vbattar1/fitnessBuddy/schematicNotes.txt.txt

Digital Output
CS.OLED
RESET.OLED
DC.OLED
(SPI)
(I2C)
SD.CS
(Optional) Card Detect 1 and 2
Digital Inputs
3x Buttons
Charge Status

Analog Inputs
Battery Monitor

Analog Outputs

Data to send to bottom board
3.3V
GND
I2C
TIA
2-3x GPIO
PPG (Pulse Sensor Circuit Output)

TOP BOARD
pins:

Power management
D27/CHRG.STATUS (Input)
A4/BATT (Input)

PPG Circuit
D29/LED.CTRL (Output)
A6/TIA (Input)
A7/PPG (Input)

OLED Pins
D3/RESET.OLED (Output)
D4/DC.OLED (Output)
D16/CS.OLED (Output)

SD Card
D5/CD1 (Input)
D7/SD.CS (Output)

Buttons Inputs
D11/SW1 (Input)
D15/SW2 (Input)
