vbattar1/fitnessBuddy/fitnessBuddy.docx

Smartwatch name: Fitness Buddy

Desired capabilities:

- Count steps
- Tell time
- Keep track of heart rate
- Keep track of calorie intake
- Goal tracking
- Blood sugar levels
- Blood pressure
- Show phone notifications
- Body temperature
- Gps
- Play music
