vbattar1/fitnessBuddy/Hardware/Top/fitnessBuddy-TOP.brd

## EAGLE design Hardware/Top/fitnessBuddy-TOP.brd (2020-10-20)

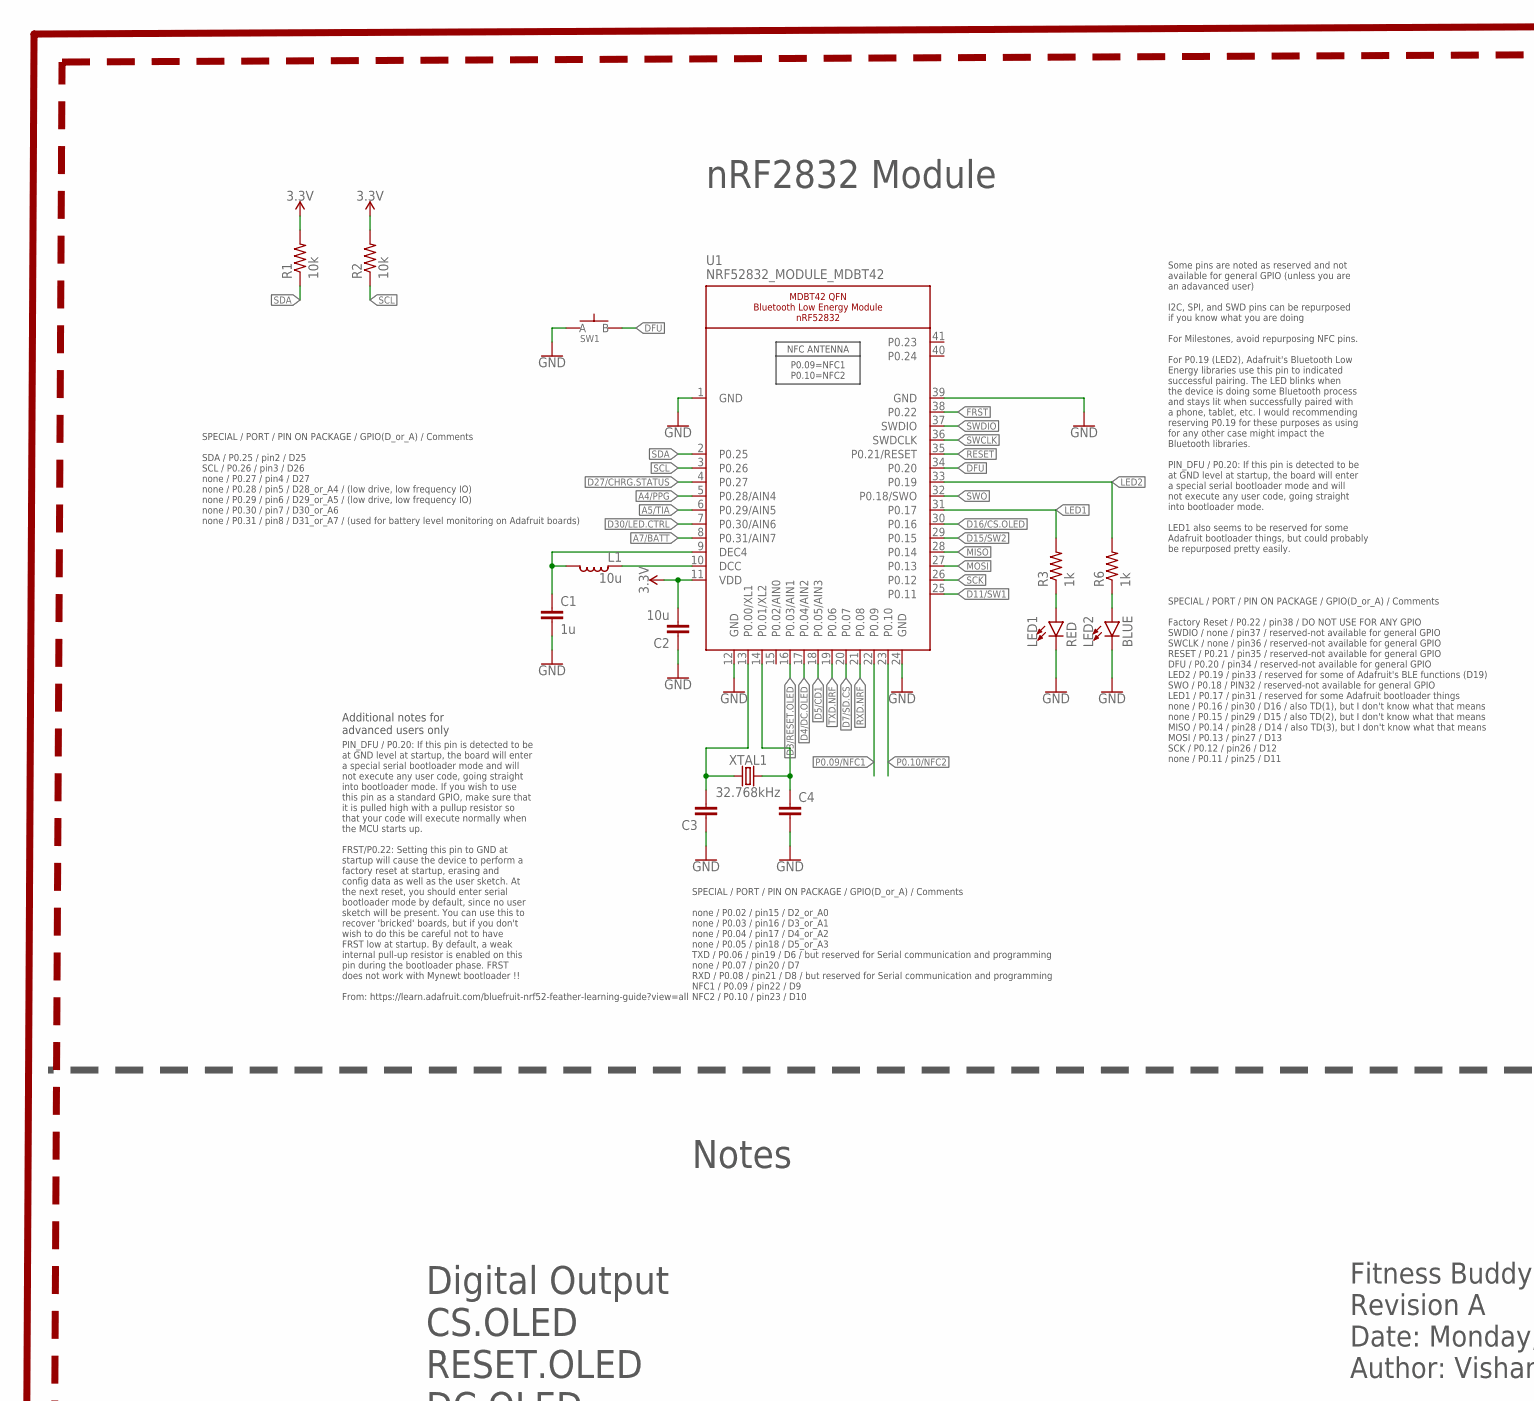
[picture p6: schematic fitnessBuddy-TOP.sch, part in row 1, column 1]

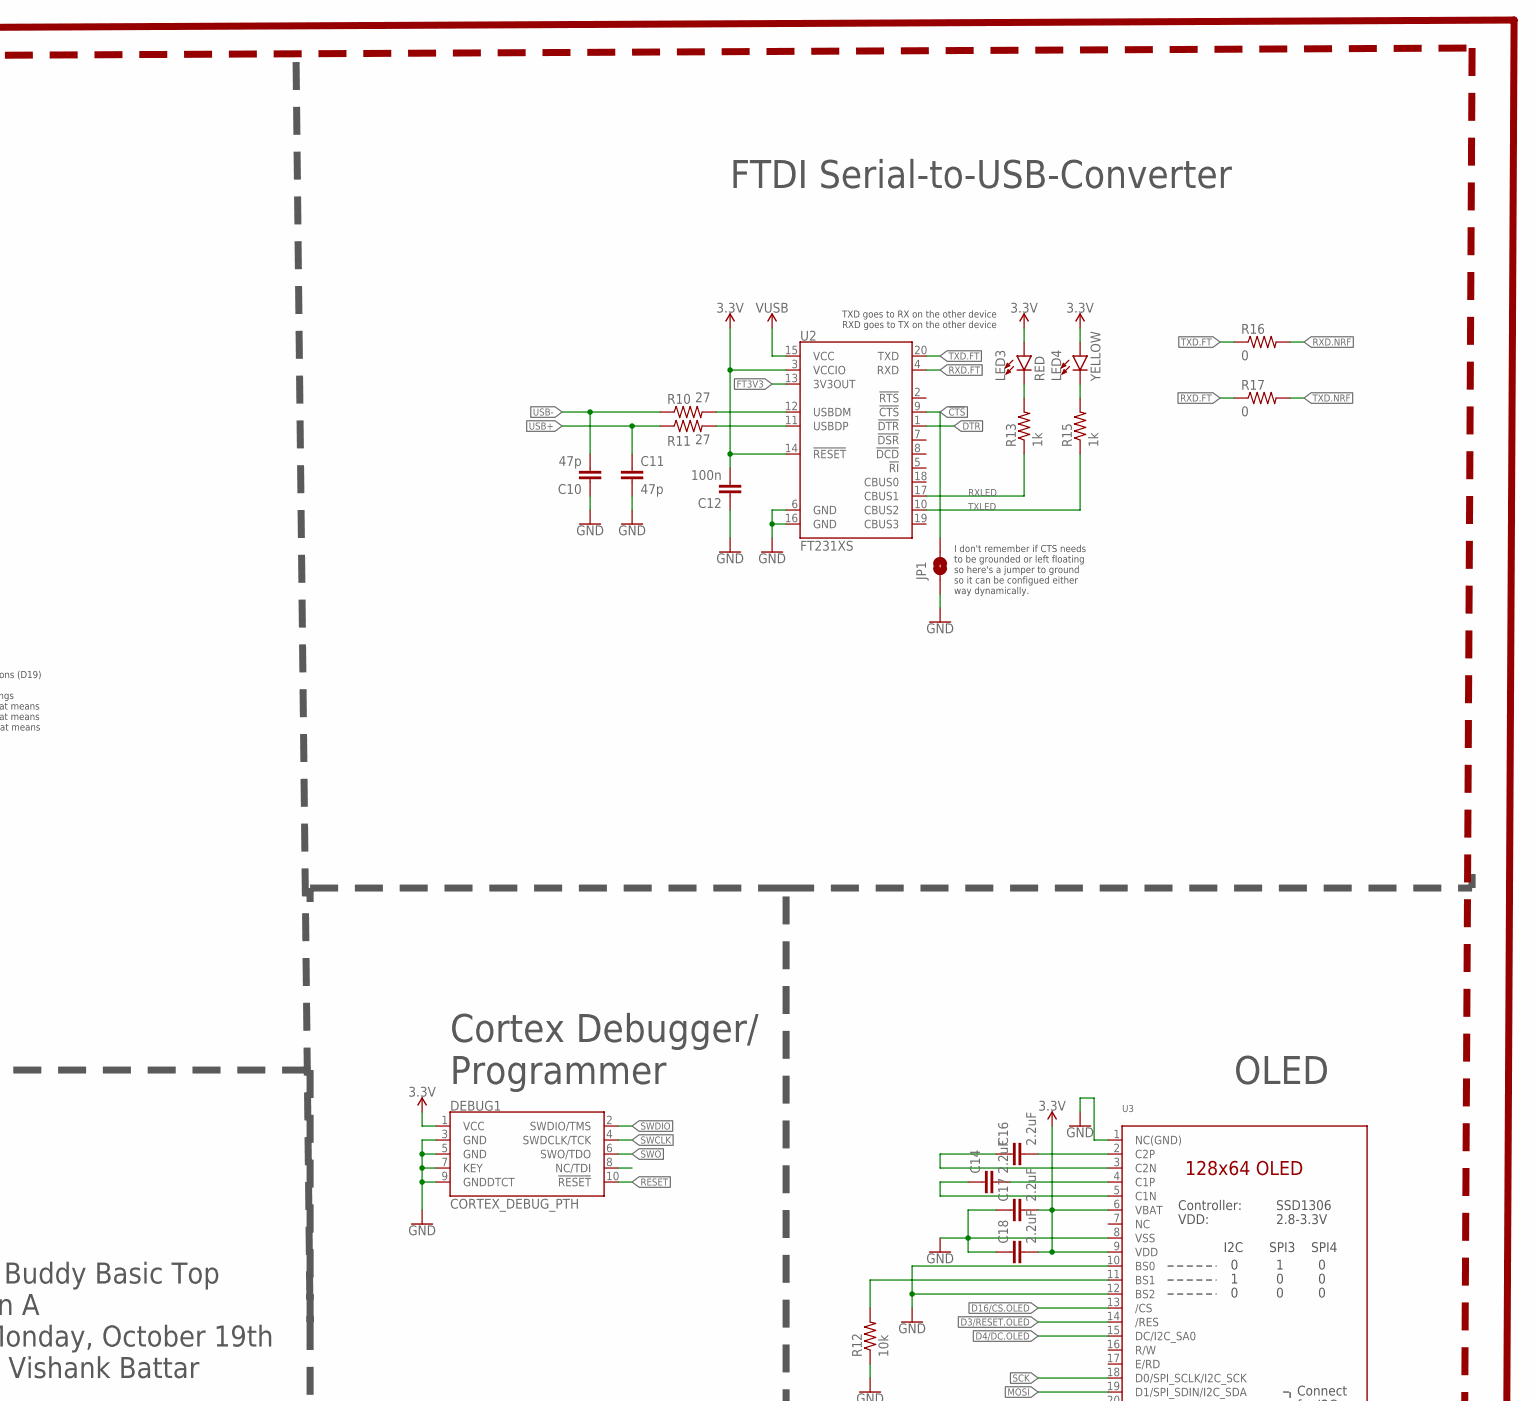
[picture p7: schematic fitnessBuddy-TOP.sch, part in row 1, column 2]

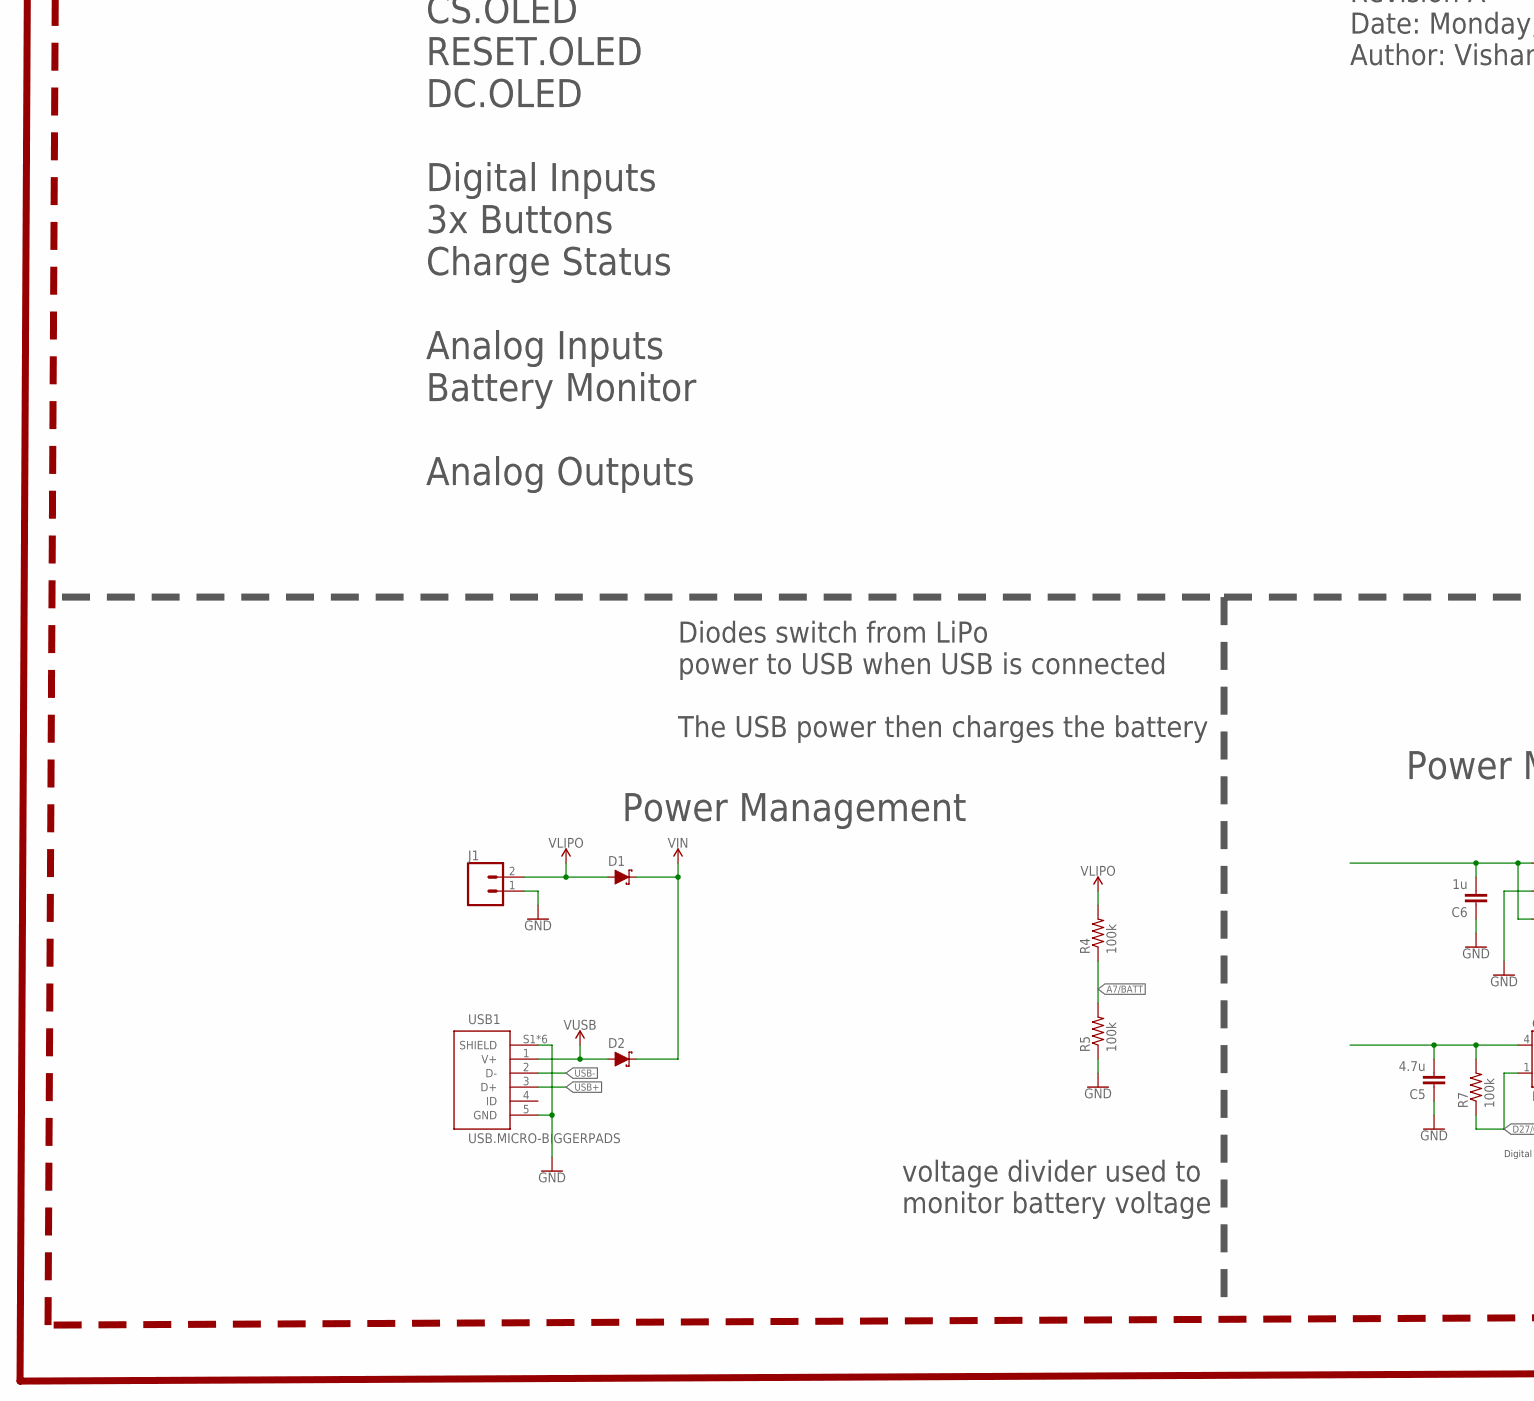
[picture p8: schematic fitnessBuddy-TOP.sch, part in row 2, column 1]

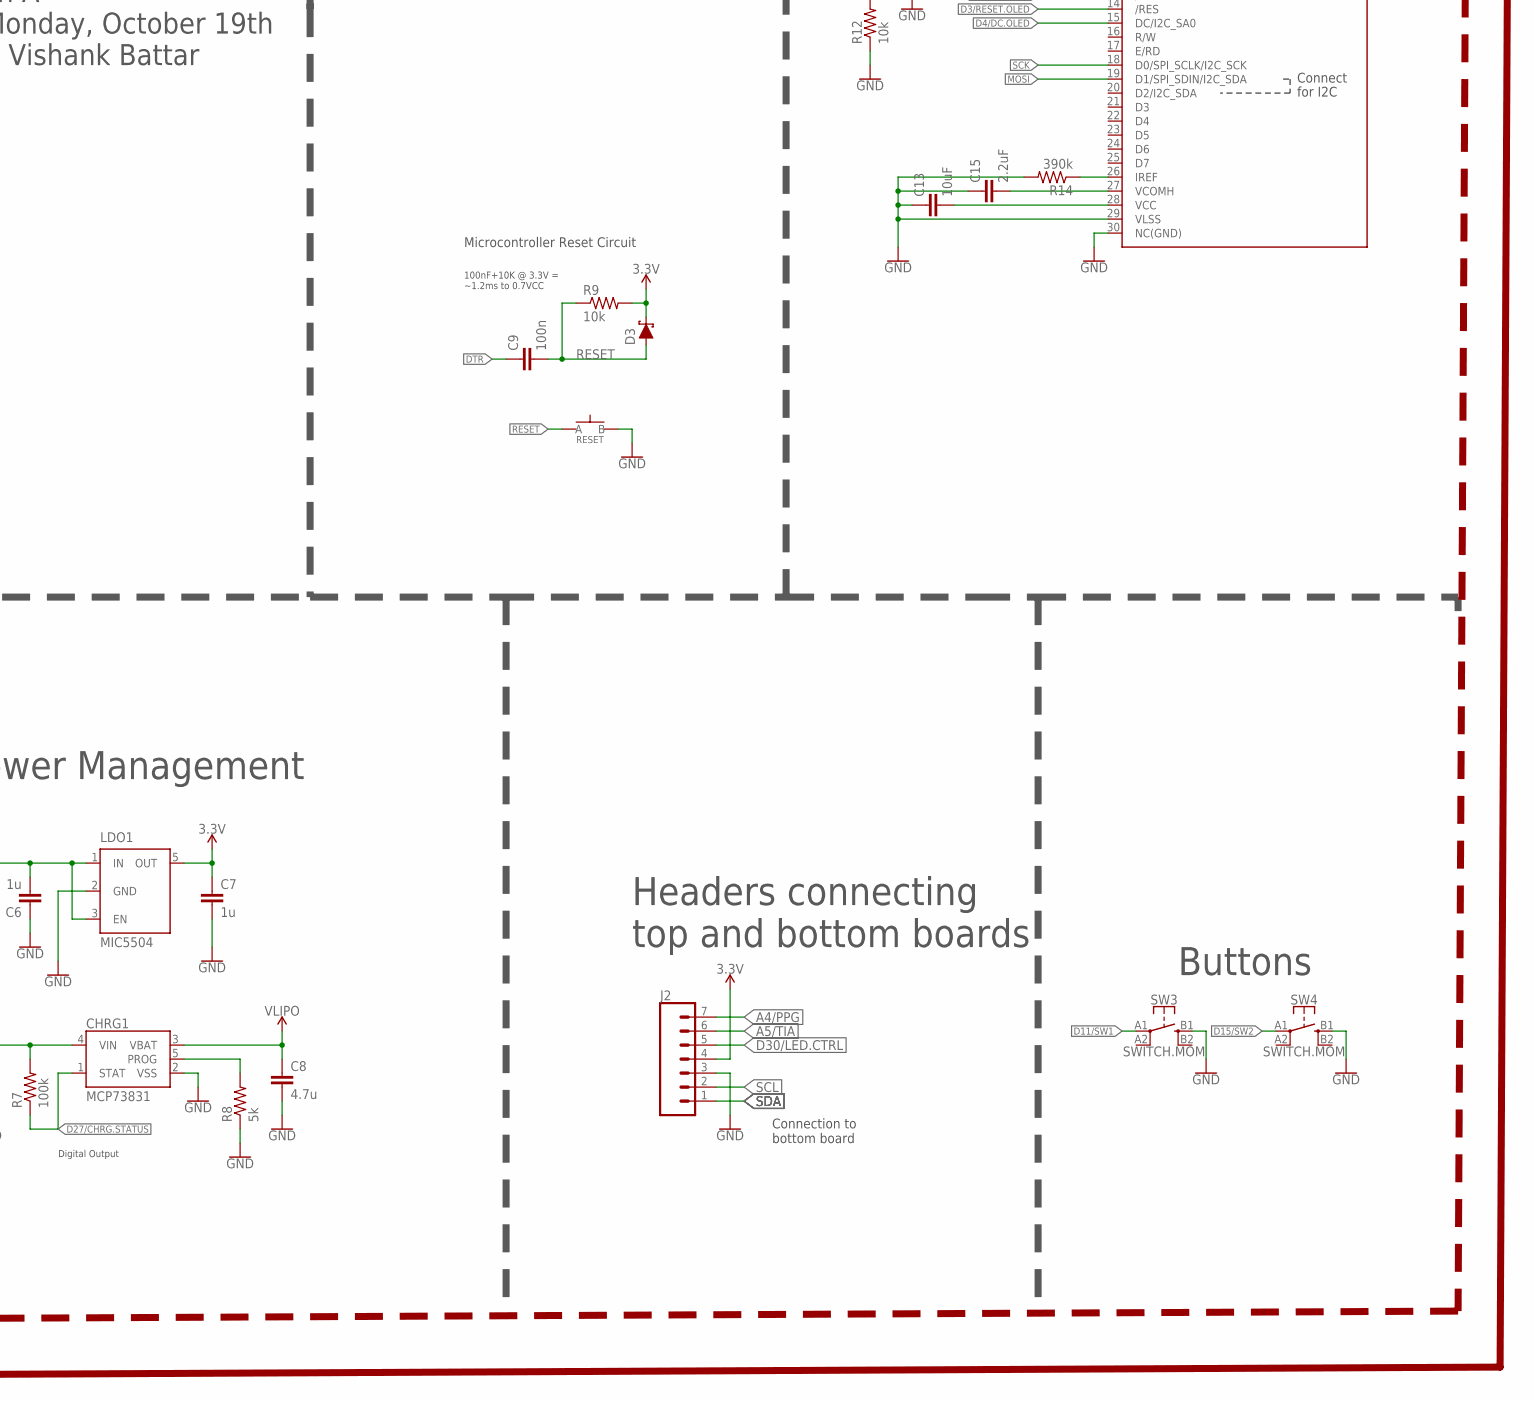
[picture p9: schematic fitnessBuddy-TOP.sch, part in row 2, column 2]

Parts:
C1, C6, C7: 1u; C0603
C2: 10u; C0805
C3, C4: CAPACITOR0603; C0603
C5, C8: 4.7u; C0603
C9, C12: 100n; C0603
C10, C11: 47p; C0603
C13: 10uF; C0603
C14, C16, C17, C18: 2.2uF; C0402
C15: 2.2uF; C0603
CHRG1: MCP73831; SOT23-5
D1, D2, D3: SCHOTTKY-USC; USC
DEBUG1: CORTEX_DEBUG_PTH; 2X5-PTH-1.27MM
J1: CONN_02; 1X02
J2: CONN_07-1.27MM; 1X07_1.27MM
JP1: JUMPER-SMT_2_NO_SILK; SMT-JUMPER_2_NO_SILK
L1: 10u; L0603
LDO1: MIC5504; SOT23-5
LED1, LED3: RED; LED-0603
LED2: BLUE; LED-0603
LED4: YELLOW; LED-0603
R1, R2, R9, R12: 10k; R0603
R3, R6, R13, R15: 1k; R0603
R4, R5, R7: 100k; R0603
R8: 5k; R0603
R10, R11: 27; R0603
R14: 390k; R0603
R16, R17: 0; R0603
RESET: SPST-PTS830GG140-COPY.1-3; BUTTON-GULLWING
SW1: SPST-PTS830GG140-COPY.1-3; BUTTON-GULLWING
SW3, SW4: SWITCH.MOM; TACTILE_SWITCH_SMD_6.2MM_TALL
U1: NRF52832_MODULE_MDBT42; BLE_MODULE_RAYTAC_MDBT42
U2: FT231XS; SSOP20_L
U3: DISP_OLED_UG-2864HSWEG01-NO-WRAPAROUND; UG-2864HSWEG01_0.96IN_NO-WRAPAROUND
USB1: USB.MICRO-BIGGERPADS; USB-MICRO-01.BIGGERPADS
XTAL1: 32.768kHz; 2-SMD.NOLEAD.2.0MMTO1.2MM

Connections:
3.3V: C2.2, C7.1, C12.2, C17.2, C18.2, D3.- (C), DEBUG1.1 (VCC), J2.4, LDO1.5 (OUT), LED3.A, LED4.A, R1.2, R2.2, R9.2, U1.11 (VDD), U2.3 (VCCIO), U2.14 (!RESET), U3.6 (VBAT), U3.9 (VDD)
!CTS: JP1.2, U2.9 (!CTS)
A4/PPG: J2.7, U1.5 (P0.28/AIN4)
A5/TIA: J2.6, U1.6 (P0.29/AIN5)
A7/BATT: R4.1, R5.2, U1.8 (P0.31/AIN7)
D3/RESET.OLED: U1.16 (P0.03/AIN1), U3.14 (/RES)
D4/DC.OLED: U1.17 (P0.04/AIN2), U3.15 (DC/I2C_SA0)
D5/CD1: U1.18 (P0.05/AIN3)
D7/SD.CS: U1.20 (P0.07)
D11/SW1: SW3.A1 (1), U1.25 (P0.11)
D15/SW2: SW4.A1 (1), U1.29 (P0.15)
D16/CS.OLED: U1.30 (P0.16), U3.13 (/CS)
D27/CHRG.STATUS: CHRG1.1 (STAT), R7.1, U1.4 (P0.27)
D30/LED.CTRL: J2.5, U1.7 (P0.30/AIN6)
DFU: SW1.3 (B), U1.34 (P0.20)
DTR: C9.1, U2.1 (!DTR)
FRST: U1.38 (P0.22)
FT3V3: U2.13 (3V3OUT)
GND: C1.2, C2.1, C3.1, C4.2, C5.1, C6.1, C7.2, C8.2, C10.1, C11.2, C12.1, C13.1, C15.1, C17.1, C18.1, CHRG1.2 (VSS), DEBUG1.3 (GND), DEBUG1.5 (GND), DEBUG1.7 (KEY), DEBUG1.9 (GNDDTCT), J1.1, J2.3, JP1.1, LDO1.2 (GND), LED1.C, LED2.C, R5.1, R8.1, R12.1, R14.2, RESET.3 (B), SW1.1 (A), SW3.B1 (3), SW4.B1 (3), U1.1 (GND), U1.12 (GND), U1.24 (GND), U1.39 (GND), U2.6 (GND), U2.16 (GND), U3.1 (NC(GND)), U3.8 (VSS), U3.10 (BS0), U3.12 (BS2), U3.29 (VLSS), U3.30 (NC(GND)), USB1.5 (GND), USB1.S1 (SHIELD), USB1.S2 (SHIELD), USB1.S3 (SHIELD), USB1.S4 (SHIELD), USB1.S5 (SHIELD), USB1.S6 (SHIELD)
LED1: R3.2, U1.31 (P0.17)
LED2: R6.2, U1.33 (P0.19)
MISO: U1.28 (P0.14)
MOSI: U1.27 (P0.13), U3.19 (D1/SPI_SDIN/I2C_SDA)
unnamed: R12.2, U3.11 (BS1)
unnamed: R14.1, U3.26 (IREF)
unnamed: C16.2, U3.2 (C2P)
unnamed: C3.2, U1.13 (P0.00/XL1), XTAL1.P$1 (1)
unnamed: C16.1, U3.3 (C2N)
unnamed: C4.1, U1.14 (P0.01/XL2), XTAL1.P$2 (2)
unnamed: C14.2, U3.4 (C1P)
unnamed: C14.1, U3.5 (C1N)
unnamed: LED1.A, R3.1
unnamed: LED2.A, R6.1
unnamed: L1.1, U1.10 (DCC)
unnamed: C1.1, L1.2, U1.9 (DEC4)
unnamed: C13.2, U3.28 (VCC)
unnamed: C15.2, U3.27 (VCOMH)
unnamed: CHRG1.5 (PROG), R8.2
unnamed: C5.2, CHRG1.4 (VIN), R7.2
unnamed: R10.2, U2.12 (USBDM)
unnamed: R11.2, U2.11 (USBDP)
unnamed: LED3.C, R13.2
unnamed: LED4.C, R15.2
P0.09/NFC1: U1.22 (P0.09)
P0.10/NFC2: U1.23 (P0.10)
RESET: C9.2, D3.+ (A), DEBUG1.10 (!RESET), R9.1, RESET.1 (A), U1.35 (P0.21/RESET)
RXD.FT: R17.1, U2.4 (RXD)
RXD.NRF: R16.2, U1.21 (P0.08)
RXLED: R13.1, U2.17 (CBUS1)
SCK: U1.26 (P0.12), U3.18 (D0/SPI_SCLK/I2C_SCK)
SCL: J2.2, R2.1, U1.3 (P0.26)
SDA: J2.1, R1.1, U1.2 (P0.25)
SWCLK: DEBUG1.4 (SWDCLK/TCK), U1.36 (SWDCLK)
SWDIO: DEBUG1.2 (SWDIO/TMS), U1.37 (SWDIO)
SWO: DEBUG1.6 (SWO/TDO), U1.32 (P0.18/SWO)
TXD.FT: R16.1, U2.20 (TXD)
TXD.NRF: R17.2, U1.19 (P0.06)
TXLED: R15.1, U2.10 (CBUS2)
USB+: C11.1, R11.1, USB1.3 (D+)
USB-: C10.2, R10.1, USB1.2 (D-)
VIN: C6.2, D1.- (C), D2.- (C), LDO1.1 (IN), LDO1.3 (EN)
VLIPO: C8.1, CHRG1.3 (VBAT), D1.+ (A), J1.2, R4.2
V_USB: D2.+ (A), U2.15 (VCC), USB1.1 (V+)

Notes on the sheet:
Microcontroller Reset Circuit
100nF+10K @ 3.3V = ~1.2ms to 0.7VCC
SPECIAL / PORT / PIN ON PACKAGE / GPIO(D_or_A) / Comments SDA / P0.25 / pin2 / D25 SCL / P0.26 / pin3 / D26 none / P0.27 / pin4 / D27 none / P0.28 / pin5 / D28_or_A4 / (low drive, low frequency IO) none / P0.29 / pin6 / D29_or_A5 / (low drive, low frequency IO) none / P0.30 / pin7 / D30_or_A6 none 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
SPECIAL / PORT / PIN ON PACKAGE / GPIO(D_or_A) / Comments none / P0.02 / pin15 / D2_or_A0 none / P0.03 / pin16 / D3_or_A1 none / P0.04 / pin17 / D4_or_A2 none / P0.05 / pin18 / D5_or_A3 TXD / P0.06 / pin19 / D6 / but reserved for Serial communication and programming none / P0.07 / pin20 / D7 RXD / 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
SPECIAL / PORT / PIN ON PACKAGE / GPIO(D_or_A) / Comments Factory Reset / P0.22 / pin38 / DO NOT USE FOR ANY GPIO SWDIO / none / pin37 / reserved-not available for general GPIO SWCLK / none / pin36 / reserved-not available for general GPIO RESET / P0.21 / pin35 / reserved-not available for general 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
Some pins are noted as reserved and not available for general GPIO (unless you are an adavanced user) I2C, SPI, and SWD pins can be repurposed if you know what you are doing For Milestones, avoid repurposing NFC pins. For P0.19 (LED2), Adafruit's Bluetooth Low Energy libraries use this pin to indic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
PIN_DFU / P0.20: If this pin is detected to be at GND level at startup, the board will enter a special serial bootloader mode and will not execute any user code, going straight into bootloader mode. If you wish to use this pin as a standard GPIO, make sure that it is pulled high with a pullup resis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
Additional notes for advanced users only
nRF2832 Module
OLED
Power Management
Buttons
Cortex Debugger/ Programmer
Digital Output CS.OLED RESET.OLED DC.OLED Digital Inputs 3x Buttons Charge Status Analog Inputs Battery Monitor Analog Outputs
TXD goes to RX on the other device RXD goes to TX on the other device
I don't remember if CTS needs to be grounded or left floating so here's a jumper to ground so it can be configued either way dynamically.
FTDI Serial-to-USB-Converter
Notes
Connection to bottom board
Digital Output
Fitness Buddy Basic Top Revision A Date: Monday, October 19th Author: Vishank Battar
Diodes switch from LiPo power to USB when USB is connected The USB power then charges the battery
voltage divider used to monitor battery voltage
Headers connecting top and bottom boards

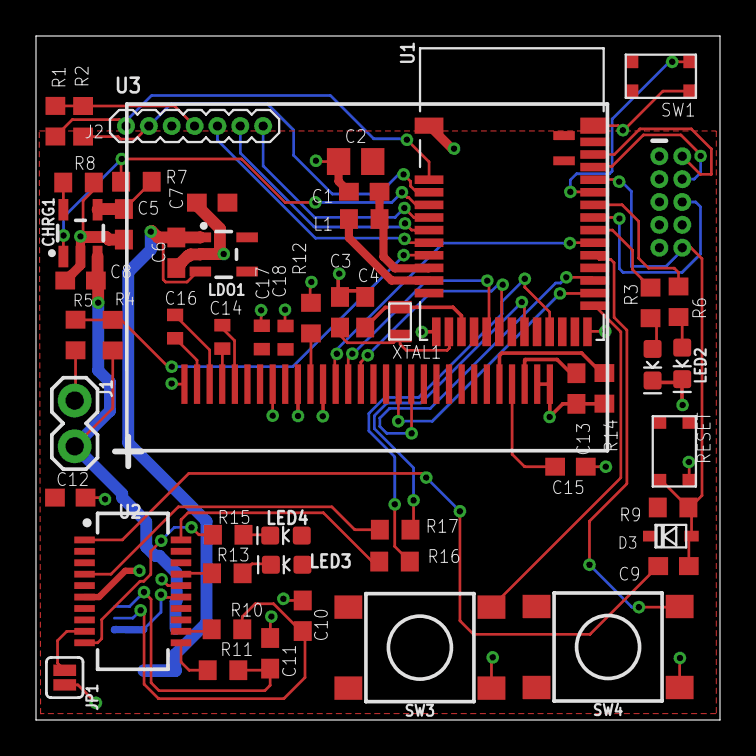
[picture p10: board fitnessBuddy-TOP.brd from above]

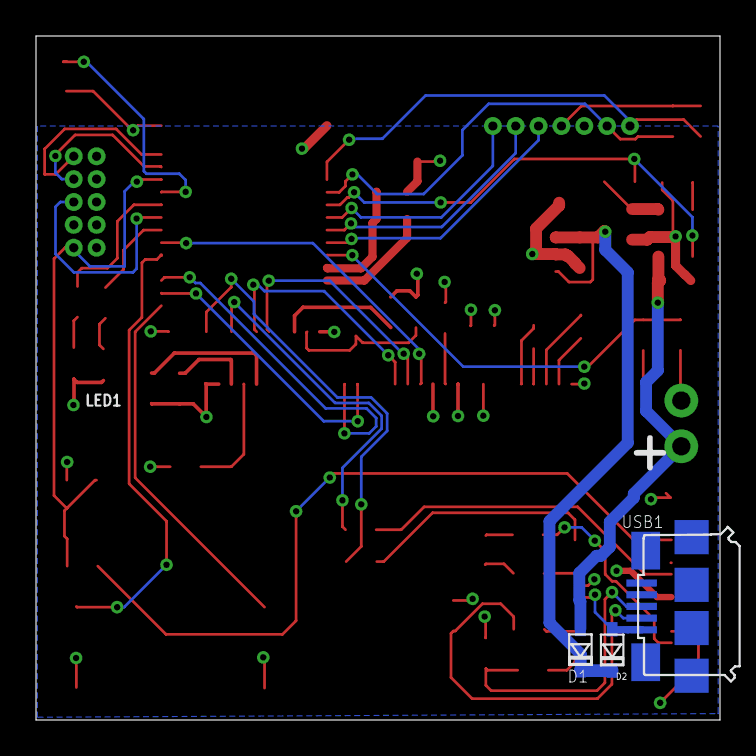
[picture p11: board fitnessBuddy-TOP.brd from below]

Board: 2 copper layers, 38.0 x 38.0 mm, 58 parts (3 on the bottom side), 56 nets.
