vbattar1/fitnessBuddy/(commit log)

2020-06-04 created new file structure for repository
    [fitnessBuddy-AUX1-BOM.xlsx, fitnessBuddy-AUX1.brd, fitnessBuddy-AUX1.sch, fitnessBuddy-AUX2-BOM.xlsx, fitnessBuddy-AUX2.brd, fitnessBuddy-AUX2.sch, fitnessBuddy-BOTTOM-BOM.xlsx, fitnessBuddy-BOTTOM.brd]
2020-06-04 created files properly through respective programs
    [fitnessBuddy-AUX1.brd, fitnessBuddy-AUX1.sch, fitnessBuddy-AUX2.brd, fitnessBuddy-AUX2.sch, fitnessBuddy-BOTTOM.brd, fitnessBuddy-BOTTOM.sch, fitnessBuddy-PPG-MODULE.brd, fitnessBuddy-PPG-MODULE.sch]
2020-06-06 imported and organized design blocks on top and bottom boards
    [fitnessBuddy-BOTTOM.brd, fitnessBuddy-BOTTOM.sch, fitnessBuddy-TOP.brd, fitnessBuddy-TOP.sch]
2020-06-06 completed adding design blocks to top and bottom boards
    [fitnessBuddy-BOTTOM.brd]
2020-06-11 added FTDI controller
    [fitnessBuddy-TOP.brd, fitnessBuddy-TOP.sch]
2020-06-18 finished bottom board and schematic
    [fitnessBuddy-BOTTOM.brd, fitnessBuddy-BOTTOM.sch, fitnessBuddy-TOP.brd, fitnessBuddy-TOP.sch]
2020-06-18 started to route bottom board
    [fitnessBuddy-BOTTOM.brd, fitnessBuddy-BOTTOM.sch]
2020-06-25 Made progress on routing bottom board
    [fitnessBuddy-BOTTOM.brd, fitnessBuddy-BOTTOM.sch, fitnessBuddy-TOP.brd, fitnessBuddy-TOP.sch]
2020-06-25 finished routing PPG Board
    [fitnessBuddy-BOTTOM.brd, fitnessBuddy-BOTTOM.sch]
2020-07-03 Began routing top board
    [fitnessBuddy-BOTTOM.brd, fitnessBuddy-TOP.brd, fitnessBuddy-TOP.sch]
2020-07-04 routed top board
    [fitnessBuddy-BOTTOM.brd, fitnessBuddy-TOP.brd, fitnessBuddy-TOP.sch]
2020-07-17 Reorganized top and bottom boards, went back and rerouted some of top board (basically did take 005 and take 006)
    [fitnessBuddy-BOTTOM.brd, fitnessBuddy-TOP.brd]
2020-07-17 finished routing power management on top board
    [fitnessBuddy-BOTTOM.brd, fitnessBuddy-TOP.brd]
2020-07-24 finished halfway through take 007. organized board/ connected airwires
    [fitnessBuddy-TOP.brd, fitnessBuddy-TOP.sch]
2020-10-19 organized top board
    [fitnessBuddy-BOTTOM.brd, fitnessBuddy-BOTTOM.sch, fitnessBuddy-TOP.brd, fitnessBuddy-TOP.sch]
2020-10-19 got rid of isolated polygons
    [fitnessBuddy-TOP.brd]
2020-10-20 reorganized bottom boards, added RTC to bottom board, and added notes to top schematic
    [fitnessBuddy-BOTTOM.brd, fitnessBuddy-BOTTOM.sch, fitnessBuddy-TOP.brd, fitnessBuddy-TOP.sch]
2020-10-28 fixed pinout connecting bottom and top boards also added ppg module files
    [KickJr-PPG-Module-BOM.xlsx, KickJr-PPG-Module.brd, KickJr-PPG-Module.sch, fitnessBuddy-BOTTOM.brd, fitnessBuddy-BOTTOM.sch, fitnessBuddy-TOP.sch]
